HeyPCB/moon-light/fab/moon_light_bom.csv

Reference | Value | Footprint | MPN | LCSC | Qty
C1 | 10uF | Capacitor_SMD:C_0805_2012Metric | CL21A106KAYNNNE | C15850 | 1
C2,C3 | 1uF | Capacitor_SMD:C_0603_1608Metric | CL10A105KB8NNNC | C15849 | 2
C4 | 100nF | Capacitor_SMD:C_0603_1608Metric | CC0603KRX7R9BB104 | C14663 | 1
C5 | 1uF | Capacitor_SMD:C_0402_1005Metric | CL05A105KA5NQNC | C52923 | 1
D1,D2,D3,D4,D5,D6,D7,D8 | Orange | LED_SMD:LED_0603_1608Metric | XL-1608UOC-06 | C965800 | 8
J1 | USB-C | Connector_USB:USB_C_Receptacle_HRO_TYPE-C-31-M-12 | TYPE-C-31-M-12 | C165948 | 1
Q1 | AO3400A | Package_TO_SOT_SMD:SOT-23 | AO3400A | C20917 | 1
R1,R2 | 5.1k | Resistor_SMD:R_0402_1005Metric | 0402WGF5101TCE | C25905 | 2
R3,R4 | 10k | Resistor_SMD:R_0402_1005Metric | 0402WGF1002TCE | C25744 | 2
R5 | 1k | Resistor_SMD:R_0603_1608Metric | 0603WAF1001T5E | C21190 | 1
R6 | 100k | Resistor_SMD:R_0603_1608Metric | 0603WAF1003T5E | C25803 | 1
R7,R8,R9,R10,R11,R12,R13,R14 | 220 | Resistor_SMD:R_0603_1608Metric | 0603WAF2200T5E | C22962 | 8
U1 | XC6206P332MR | Package_TO_SOT_SMD:SOT-23-3 | XC6206P332MR-G | C5446 | 1
U2 | CH32V003F4P6 | Package_SO:TSSOP-20_4.4x6.5mm_P0.65mm | CH32V003F4P6 | C5187096 | 1
U3 | APDS-9306-065 | OptoDevice:Broadcom_DFN-6_2x2mm_P0.65mm | APDS-9306-065 | C2649498 | 1
