HeyPCB/moon-light/fab/moon_light.step

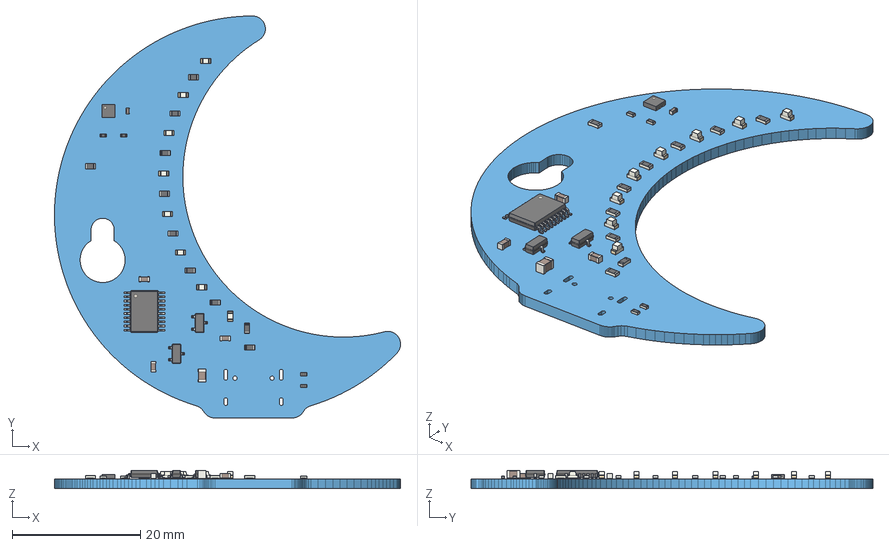
[picture p4: CAD file, 2026-10-05]
fab/moon_light.step
53.9 x 62.6 x 2.84 mm
LED_0603_1608Metric x 8
R_0603_1608Metric x 10
TSSOP-20_4.4x6.5mm_P0.65mm
R_0402_1005Metric x 4
DFN-6-1EP_2x2mm_Pitch0.65mm
C_0805_2012Metric
SOT-23-3
SOT-23
C_0603_1608Metric x 3
C_0402_1005Metric
moon_light_PCB
