HeyPCB/moon-light/fab/moon_light_schematic.pdf

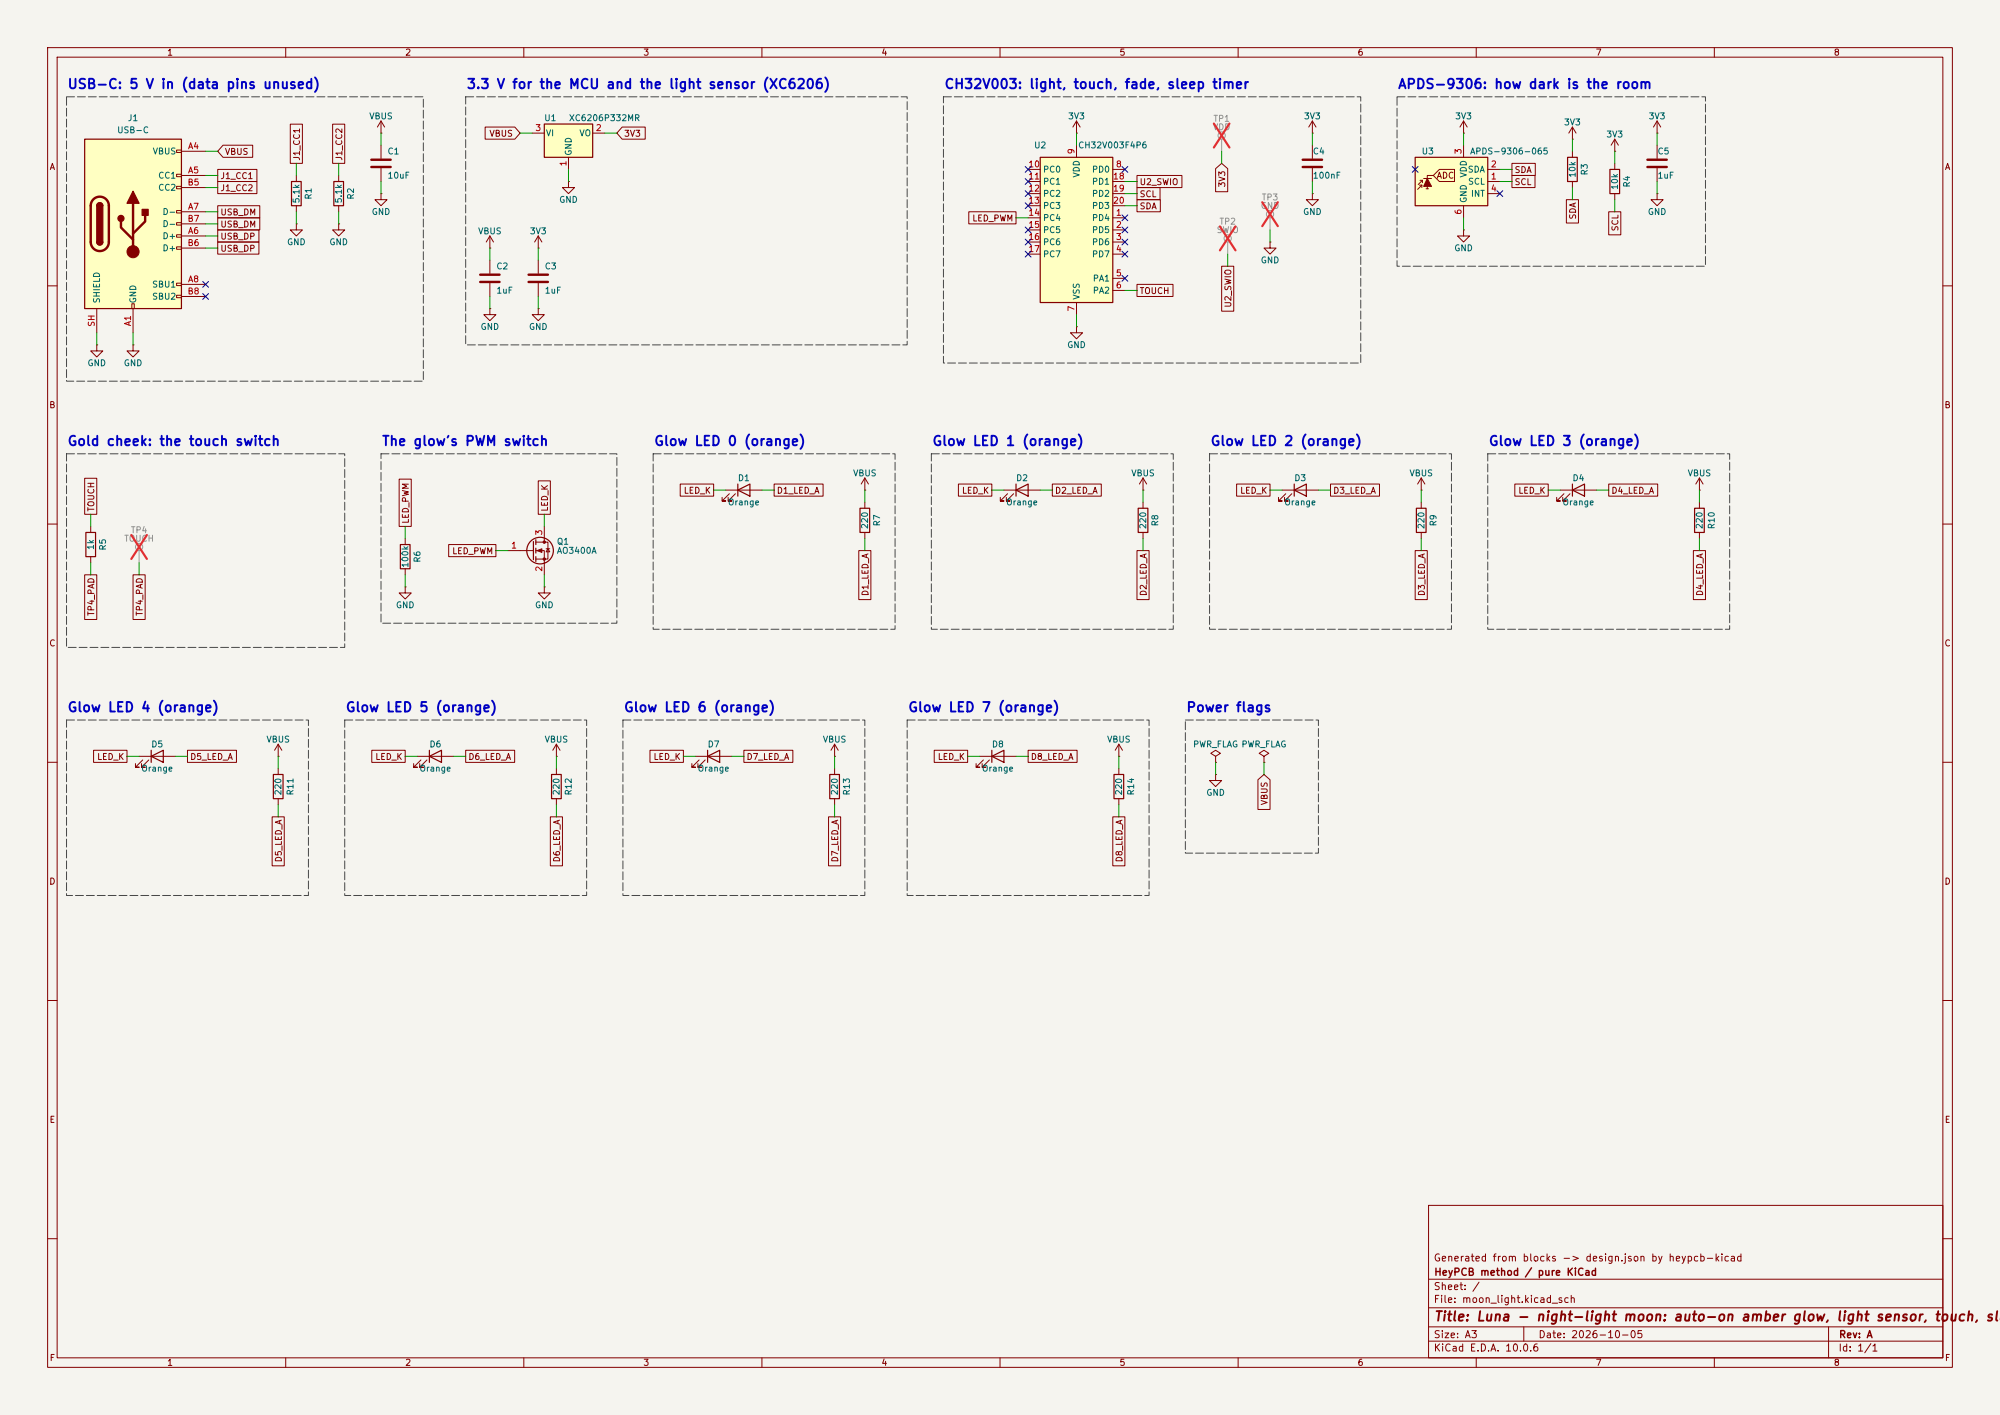
[picture p5: page 1]

CH32V003: light, touch, fade, sleep timer

APDS-9306: how dark is the room

HeyPCB method / pure KiCad
Sheet: /
File: moon_light.kicad_sch
Title: Luna - night-light moon: auto-on amber glow, light sensor, touch, sleep timer, USB-C

Size: A3 | Rev: A | F Date: 2026-10-05
KiCad E.D.A. 10.0.6 | Id: 1/1
