HeyPCB/moon-light/kicad/moon_light.kicad_pcb

## KiCad design kicad/moon_light.kicad_pcb (2026-10-05)

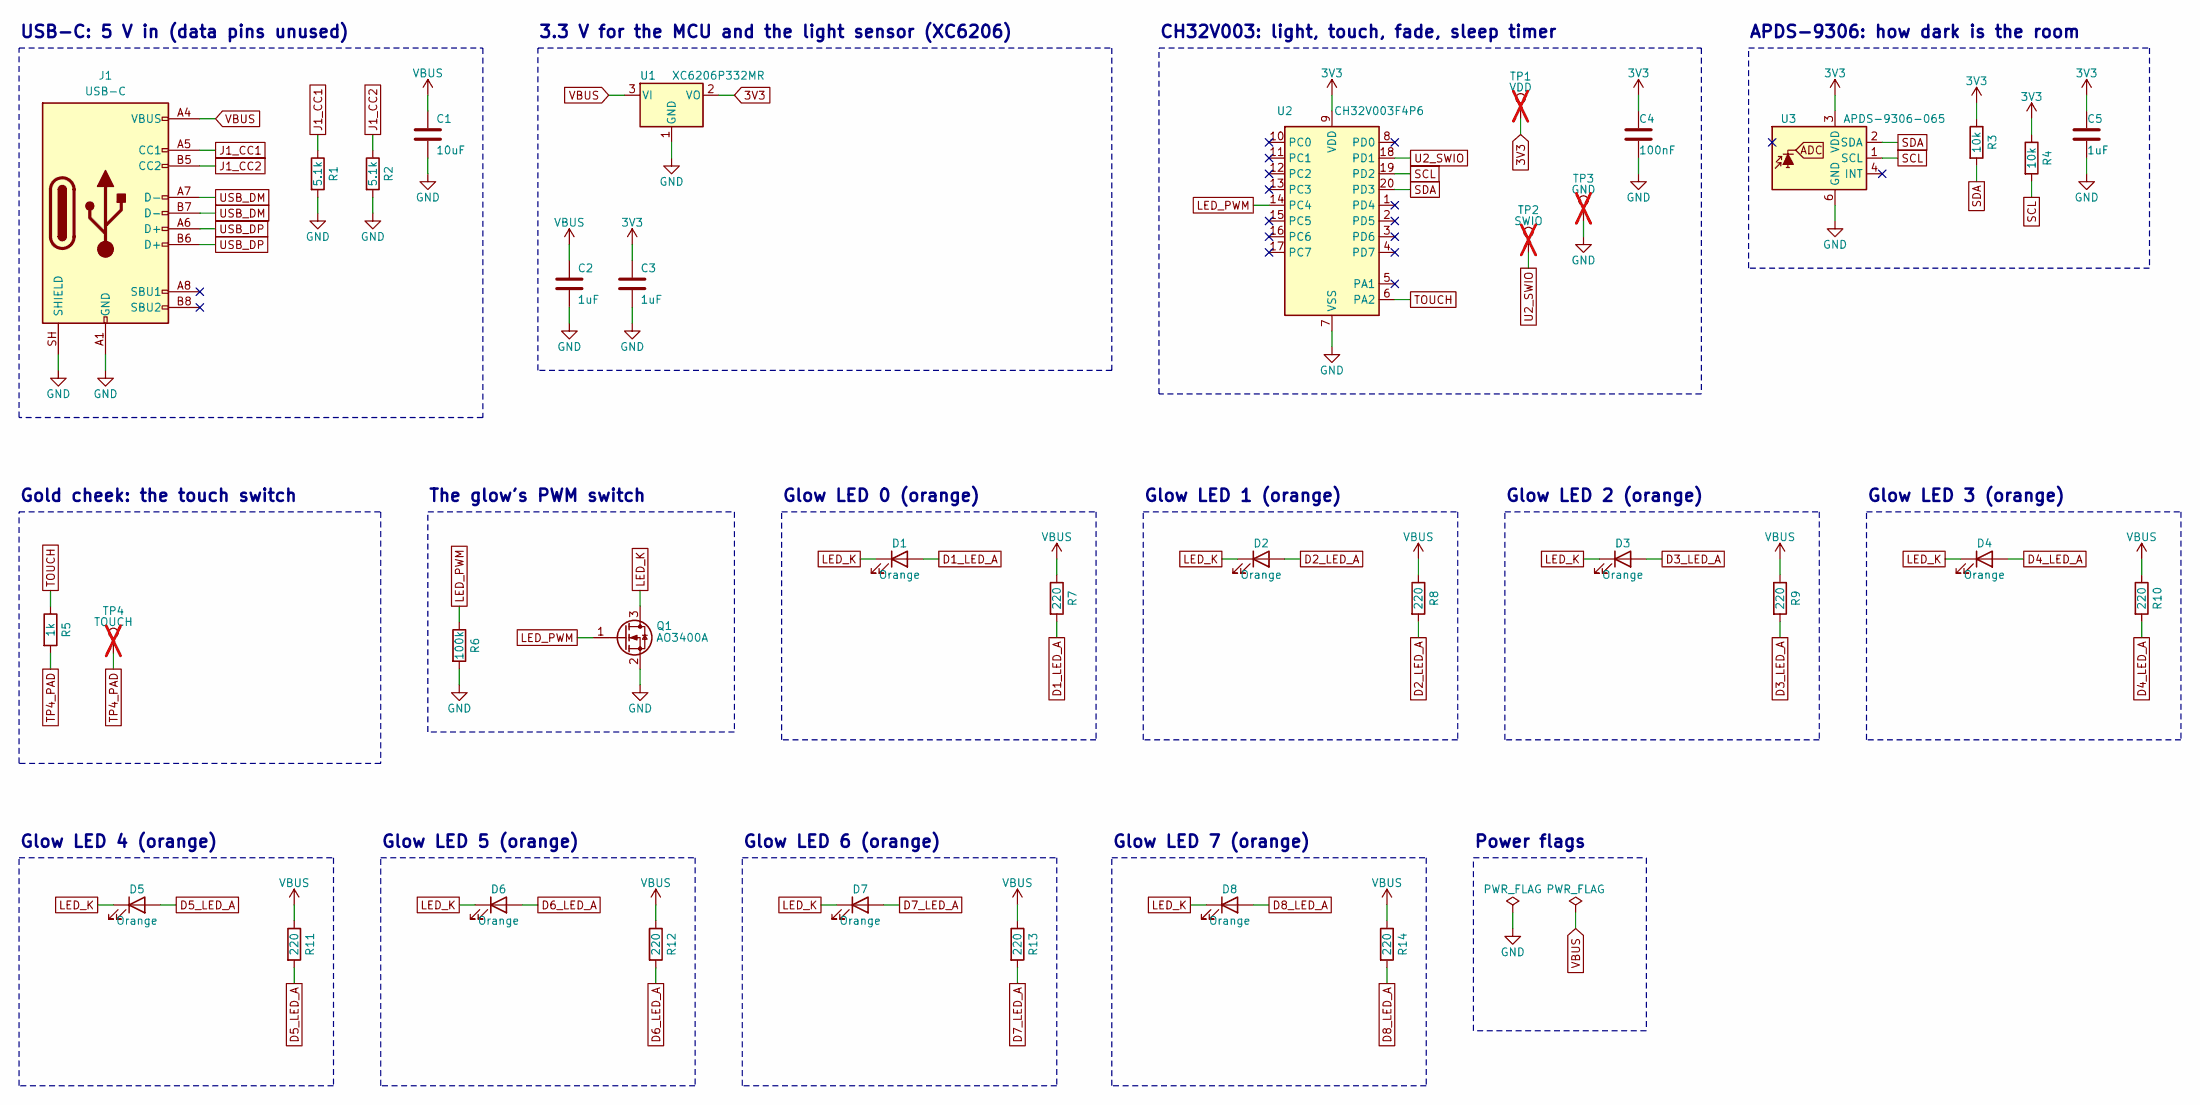
[picture p6: schematic moon_light.kicad_sch, Luna - night-light moon: auto-on amber glow, light sensor, …]

Parts:
C1: 10uF; C_0805_2012Metric; MPN CL21A106KAYNNNE; LCSC C15850
C2, C3: 1uF; C_0603_1608Metric; MPN CL10A105KB8NNNC; LCSC C15849
C4: 100nF; C_0603_1608Metric; MPN CC0603KRX7R9BB104; LCSC C14663
C5: 1uF; C_0402_1005Metric; MPN CL05A105KA5NQNC; LCSC C52923
D1, D2, D3, D4, D5, D6, D7, D8: Orange; LED_0603_1608Metric; MPN XL-1608UOC-06; LCSC C965800
J1: USB-C; USB_C_Receptacle_HRO_TYPE-C-31-M-12; MPN TYPE-C-31-M-12; LCSC C165948
Q1: AO3400A; SOT-23; MPN AO3400A; LCSC C20917
R1, R2: 5.1k; R_0402_1005Metric; MPN 0402WGF5101TCE; LCSC C25905
R3, R4: 10k; R_0402_1005Metric; MPN 0402WGF1002TCE; LCSC C25744
R5: 1k; R_0603_1608Metric; MPN 0603WAF1001T5E; LCSC C21190
R6: 100k; R_0603_1608Metric; MPN 0603WAF1003T5E; LCSC C25803
R7, R8, R9, R10, R11, R12, R13, R14: 220; R_0603_1608Metric; MPN 0603WAF2200T5E; LCSC C22962
TP1: VDD; TestPoint_Pad_1.0x1.0mm; not fitted
TP2: SWIO; TestPoint_Pad_1.0x1.0mm; not fitted
TP3: GND; TestPoint_Pad_1.0x1.0mm; not fitted
TP4: TOUCH; TestPoint_Pad_D4.0mm; not fitted
U1: XC6206P332MR; SOT-23-3; MPN XC6206P332MR-G; LCSC C5446
U2: CH32V003F4P6; TSSOP-20_4.4x6.5mm_P0.65mm; MPN CH32V003F4P6; LCSC C5187096
U3: APDS-9306-065; Broadcom_DFN-6_2x2mm_P0.65mm; MPN APDS-9306-065; LCSC C2649498

Connections:
3V3: C3.1, C4.1, C5.1, R3.1, R4.1, TP1.1, U1.2 (VO), U2.9 (VDD), U3.3 (VDD)
D1_LED_A: D1.2 (A), R7.2
D2_LED_A: D2.2 (A), R8.2
D3_LED_A: D3.2 (A), R9.2
D4_LED_A: D4.2 (A), R10.2
D5_LED_A: D5.2 (A), R11.2
D6_LED_A: D6.2 (A), R12.2
D7_LED_A: D7.2 (A), R13.2
D8_LED_A: D8.2 (A), R14.2
GND: C1.2, C2.2, C3.2, C4.2, C5.2, J1.A1 (GND), J1.A12 (GND), J1.B1 (GND), J1.B12 (GND), J1.SH (SHIELD), Q1.2 (S), R1.2, R2.2, R6.2, TP3.1, U1.1 (GND), U2.7 (VSS), U3.6 (GND)
J1_CC1: J1.A5 (CC1), R1.1
J1_CC2: J1.B5 (CC2), R2.1
LED_K: D1.1 (K), D2.1 (K), D3.1 (K), D4.1 (K), D5.1 (K), D6.1 (K), D7.1 (K), D8.1 (K), Q1.3 (D)
LED_PWM: Q1.1 (G), R6.1, U2.14 (PC4)
SCL: R4.2, U2.19 (PD2), U3.1 (SCL)
SDA: R3.2, U2.20 (PD3), U3.2 (SDA)
TOUCH: R5.1, U2.6 (PA2)
TP4_PAD: R5.2, TP4.1
U2_SWIO: TP2.1, U2.18 (PD1)
USB_DM: J1.A7 (D-), J1.B7 (D-)
USB_DP: J1.A6 (D+), J1.B6 (D+)
VBUS: C1.1, C2.1, J1.A4 (VBUS), J1.A9 (VBUS), J1.B4 (VBUS), J1.B9 (VBUS), R7.1, R8.1, R9.1, R10.1, R11.1, R12.1, R13.1, R14.1, U1.3 (VI)

Notes on the sheet:
USB-C: 5 V in (data pins unused)
3.3 V for the MCU and the light sensor (XC6206)
CH32V003: light, touch, fade, sleep timer
APDS-9306: how dark is the room
Gold cheek: the touch switch
The glow's PWM switch
Glow LED 0 (orange)
Glow LED 1 (orange)
Glow LED 2 (orange)
Glow LED 3 (orange)
Glow LED 4 (orange)
Glow LED 5 (orange)
Glow LED 6 (orange)
Glow LED 7 (orange)
Power flags

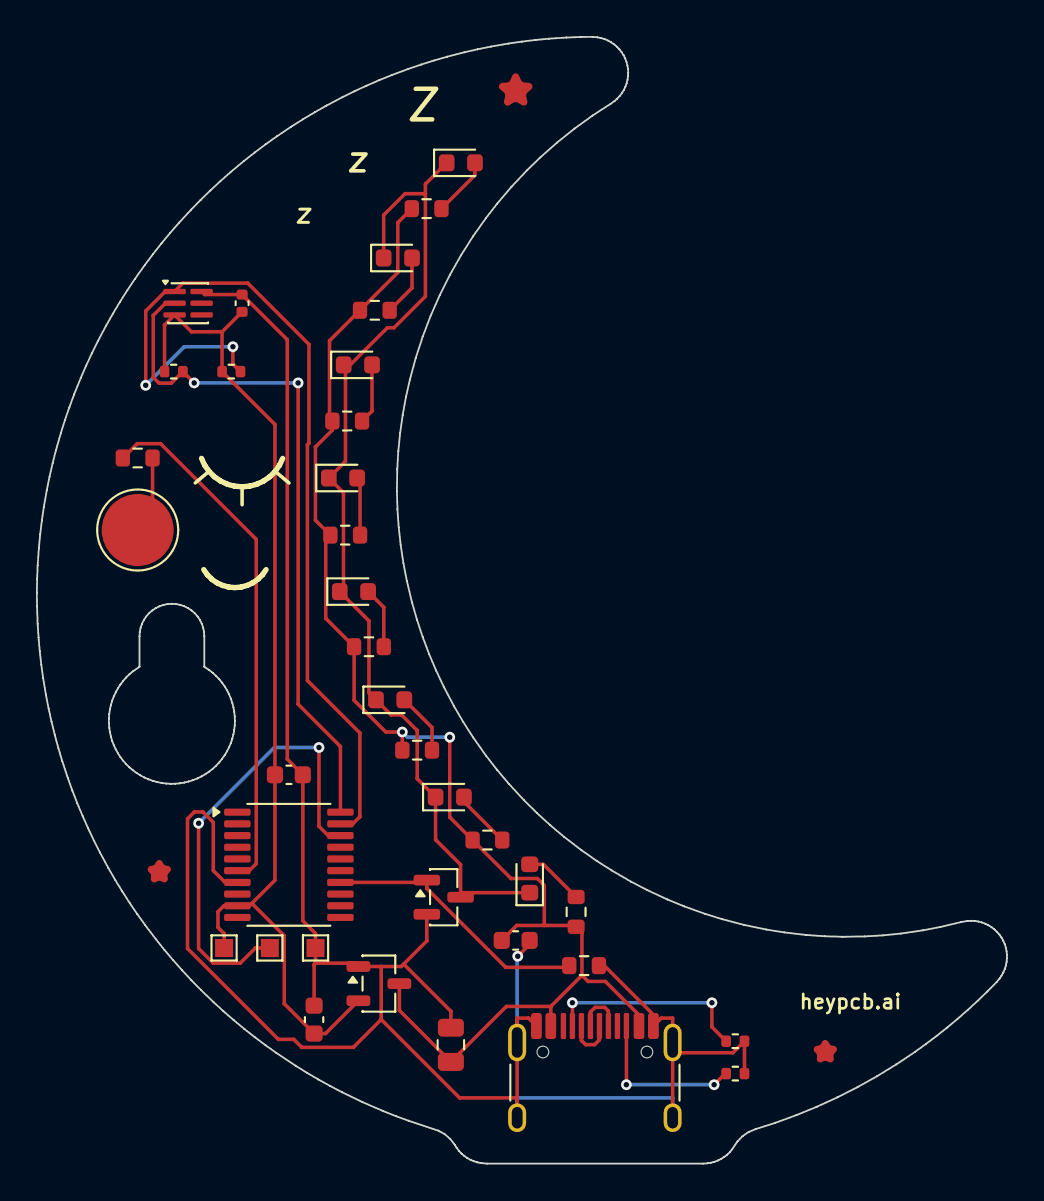
[picture p7: board moon_light.kicad_pcb from above]

Board: 2 copper layers, 53.9 x 62.6 mm, 36 parts (0 on the bottom side), 22 nets.
